Narutimo/compressor/КР_Рычков.pdf

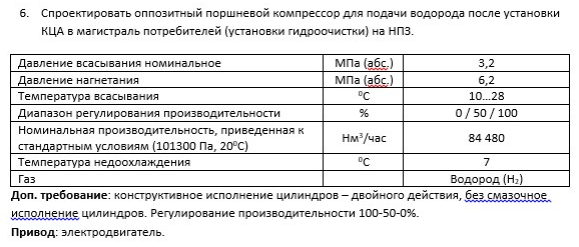
[picture p1: figure]

## Тепловой расчет

### Исодные данные

Давление всасывания | p вс := 3.2 MPa
Давление нагнетания | pн

:= 6.2 MPa

Tвс := 301.15Δ°C Температура всасывания

Номинальная производительность,
приведенная к стандартным условиям

Vн

84480

m

3

hr

:= |
Стандартная температру всасывания | Tс

:= 293.15Δ°C

Стандартное давление всасывания | p с

:= 101300 Pa

Недоохлаждение | ΔT | 7 := Δ°C

Газ - Водород Н2
k | 1.41 := Показатель адиабаты
Индивидуальная газовая постоянная | R | 4125 J kg K
:= |
Давление н.у. | p
0

:= 101325 Pa

Температура н.у. | T0

:= 273.15Δ°C

Массовый расход G

p

### 0 Vн

R T0

2.11

kg
s

:= =

## Расчет

## 1. Распределение давления по ступеням

Общее номенальное относительное повышение давления в компрессоре:

ε
к

pн
p
вс

:= = 1.938

Относительные потери давления в ступени I:
A := 2.66 | q | 0.25 :=
A , q - коэффициенты,учитывающие современное газодинамическое совершенство клапанов

δ
вс1 0.3

A

p
вс

### 1 Pa

q

- 0.3

2.66

### 3.2 MPa

Pa

0.25

:= | = | | = 0.019
δн1 | 0.7

A

pн

### 1 Pa

q

- 0.7

2.66

### 6.2 MPa

Pa

0.25

:= | = | | = 0.037

Усредненные давления p1 и p2:

p

1I | 1 δ
вс1 ( | ) - | p
вс | 3.14 106
:= | = | | Pa

p

2I | 1 δн1 ( | ) + | pн
- 6.431 106
:= | = | | Pa

Номинальное давление:

p

всI p

вс 3.2 106
:= | = | | Pa
pнI | pн

6.2 106
:= | = | | Pa

Относительное повышение давления в цилиндрах:

εцI

p
2I
p
1I

:= = 2.048

## 2. Определение коэффициента подачи

Определение коэффициентов сжимаемости

Избыточный объем газа | b | 0.6 10- 3

m

3

kg

:= |

β

b
273 R

0.6 10- 3

m

3

kg

273 4125

J
kg K
= | 5.328 10- 10

m s

2
- K
kg
= | = | - Показатель отклонения сжимаемости

v

### 0 R

T0
p
0
- 11.12

m

3

kg

:= =

СТВ I ступени:
TвсI | Tвс := | = 301.15 K

v

всI R

TвсI
p
всI

+ 273β

- 0.389

m

3

kg

:= | =

ρвсI

p

всI v

всI

p
0

v
0

:= | = 1.104

ξ

всI | ρвсI
| 273 Tвс
- 1.001

1
K
:= | = | - Коэффициент сжимаемости

СТН I ступени:

TнI Tвс εцI

k 1-
k
:= | | = 370.97 K
vнI | R
| TнI
| p
2I
| | + 273β
- 0.239

m

3

kg

:= | =

ρнI

p

2I vнI

p
0

v
0

:= | = 1.362
ξнI | ρнI
| 273 TнI
- 1.002

1
K
:= | =

mI

:= 1.4

Величина относительного мертвого объема:

amI := 0.06

λоI 1 amI

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
- - 1
:= - | | = 0.961

Коэффициент дросселирования:
Принимаем
λдрI := 0.98 | ступень высокого давления

Коэффициент подогрева:

λтI | 1 0.01 εцI := - | ( | ) - 1 = 0.99

Коэффициент плотности:

λплI := 0.97

Коэффициенты подачи ступеней:

λI | λоI λдрI | λтI | λплI := | | = 0.904

## 3. Определение основных размеров ступени

Производительность компрессора, приведенная к условиям всасывания:

Ve Vн

p
с
Tс

Tвс
p
вс
- 0.763

m

3

s

:= | =

Объем, описываемый цилиндром I ступени:

VhI

Ve
λI

2

0.422

m

3

s

:= =

Частота вращения вала - 490 об/мин

n
0

490

### 60 s

8.167

1
s
:= | = | частота вращение асинхронного электродвигателя
Средняя скоротсь поршня: | Cm
3.75

m
s
:= |
Ход поршня: | Sп

Cm

### 2 n0

:= | = 0.23 m
Относительный диаметр штока крейцпкофа: | αшт := 0.15
Диаметр цилиндра I ступени: | DI

### 4 VhI

π Sп

- n
0
- 2 αшт

2

:= | = 0.381 m

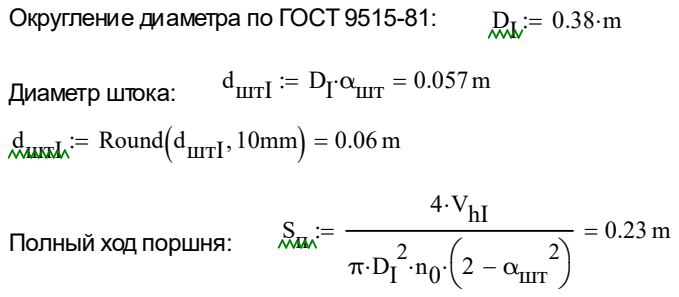
[picture p2: figure]
Округление диаметра по ГОСТ 9515-81:; dштI; DI αшт :=; = 0.057 m Диаметр штока:; Round dштI :=; 4 VhI; 2 αшт; = 0.23 m Полный ход поршня:

Уточнение средней скорости поршня:

Cm

### 2 Sп

- n
0
- 3.763

m
s
:= | =

Проверка:
Sп

n
0

2
- 15.366

m

s

2

= ψ

Sп
DI

:= = 0.606

Уточнение описанных объемов цилиндров:

VhI

π DI

2
- 2 αшт

2

4

Sп

- n
0
- 0.422

m

3

s

:= | =

Рабочие площади:

FпI

π DI

2

4

0.113 m2
:= | = | FпшI

π DI

2
- 1 αшт

2

4

0.111 m2
:= | =

Для I поршня:
PгвI | p
2I FпI | p
1I FпшI | p
0
FпI FпшI | + ( | ) -

- 3.811 105
:= | = | | N
PгнI | p
1I FпI | p
2I FпшI | p
0
FпI FпшI | + ( | ) -

- -3.572 105
:= | = | | N

## Построение индикаторных диаграмм:

Мертвые объемы:

VмI | VhI amI | 0.025

m

3

s

:= | =
V1I | VмI VhI + | 0.447

m

3

s

:= | =
V2I | V1I

p
1I
p
2I

1
k
- 0.269

m

3

s

:= | =
V4I | VмI

p
2I
p
1I

1
k
- 0.042

m

3

s

:= | =
v | VмI 1.01 VмI , | | V1I := | ..

p

Iн( ) p v
1I

V1I
v

k
- | V2I v V1I if |

p

2I | VмI < v V2I if | <

:=

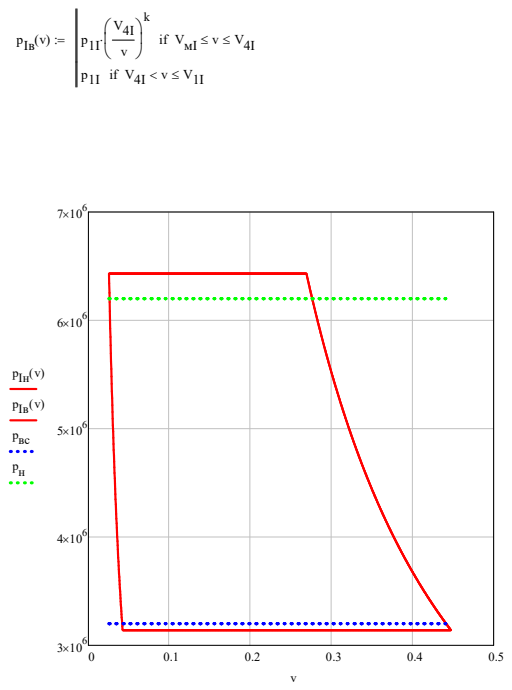
[picture p3: page 7]
VмI v V4I if

### Мощность привода компрессора

Коэффициенты возврата энергии:

ΘI

### 1 amI εцI

1
k
- 1
:= - | | = 0.96

### Определение мощности:

NиндI | p
1I VhI | ΘI

k
k 1 -
- εцI

k 1-
k
- 1
- 1.014 106
:= | = | | W
Nинд.к | 2NиндI 2.029 106
:= | = | | W

ηмех := 0.98

Ne0

Nинд.к
ηмех

2.07 106
:= | = | | W | мощность на валу компрессора
Запас по мощности | n
з
| | | := 10%

Ne

Nинд.к
ηмех
| 1 nз
( | ) + | 2.277 106
:= | = | | W | мощность электродвигателя

Привод компрессора осуществляется от асинхронного двигателя через упругую муфту. Зададимся частотой вращения вала ЭД:
n
0
500 min- 1 | 8.333
| 1 s
:= | =
ω0

2π n
0
- 52.36

1
s

:= =

Mном

Ne
ω0

4.349 104
:= | = | | J

Асинхронная частота вращения при заданной нагрузке n 490min- 1
:=

## Динамический расчет

### Исходные данные

Радиус кривошипа | Rк

Sп
2
:= | = 0.115 m
Отношение радиуса кривошипа к длине шатуна | λR

1
5

:=

Длина шатуна | lш

Rк
λR
:= | = 0.576m
ω | 2π n
0
- 52.36

1
s
:= | | =
α := 0 0.36deg , | | .. 360deg
β( ) | asin α | λR
:= | ( | ) sin( ) α

Sx

( ) | R α | к
( | ) 1 cos - | ( ) α

λR
4
+ | ( | ) 1 cos 2 - | ( ) α
:= |
Sx.1( ) | R α | к
:= | ( | ) 1 cos - | ( ) α

Sx.2( ) α

λR
4

Rк

:= | ( | ) 1 cos 2 - | ( ) α

Cx

( ) | R α | к

ω

| sin( | | ) α β α + ( )
cos( | ) β α( )
:= |
Cx.1( ) | R α | к
:= | ωsin( ) α
Cx.2( ) | R α | к

ω

λR
2
:= | | sin 2( ) α

jx

( ) α
α

Cx

| ( ) α

d
d
:= | ω

jx.1( ) α
α
| Cx.1( ) α

d
d
:= | ω

jx.2( ) α
α

Cx.2( ) α

d
d
:= | ω

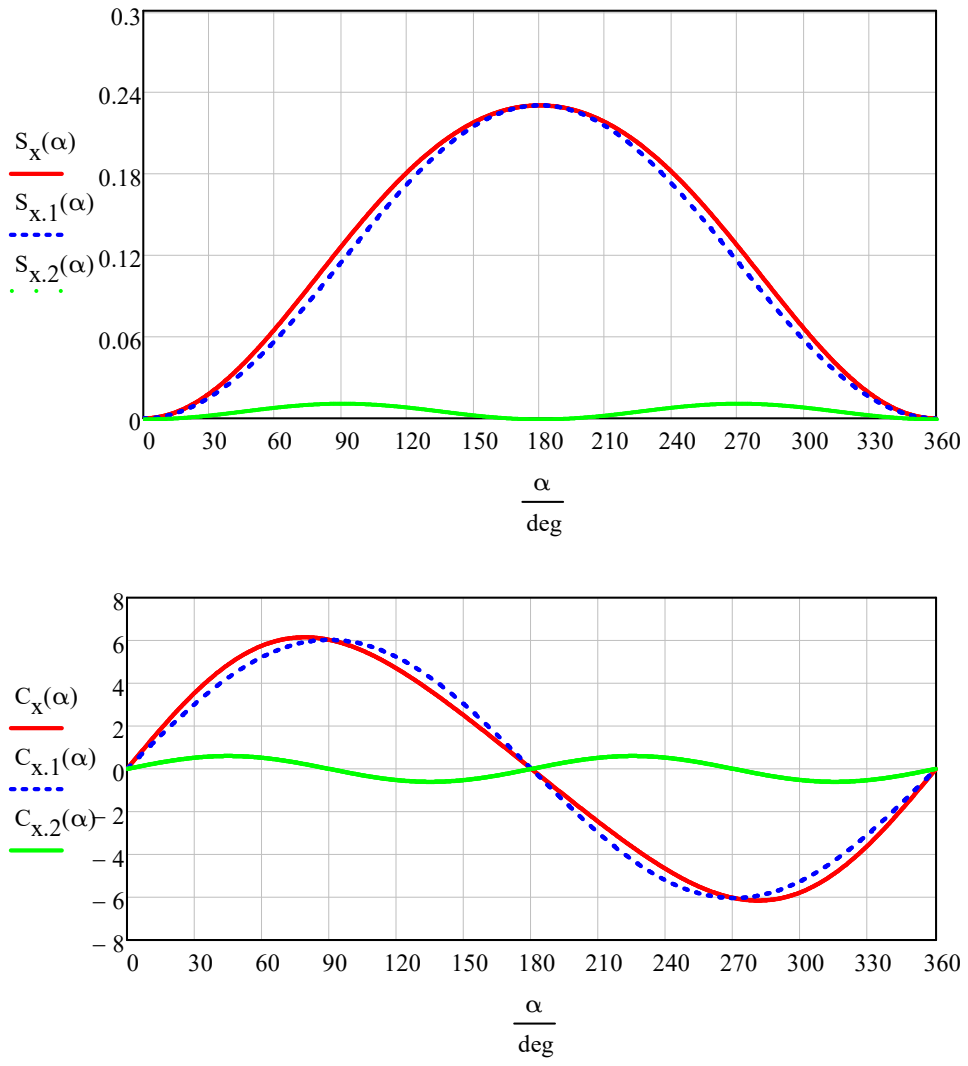
[picture p4: page 10]
deg

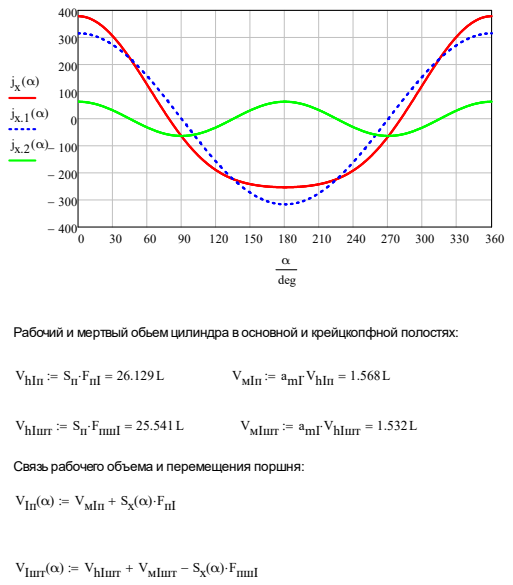
[picture p5: page 11]
deg; VhIп; FпI :=; VмIп; amI VhIп :=; VhIшт; FпшI :=; VмIшт; amI VhIшт :=; VIп( ); мIп Sx; VIшт( ); hIшт VмIшт +; ( ) F α пшI :=

Рабочий и мертвый обьем цилиндра в основной и крейцкопфной полостях:

Связь рабочего объема и перемещения поршня:

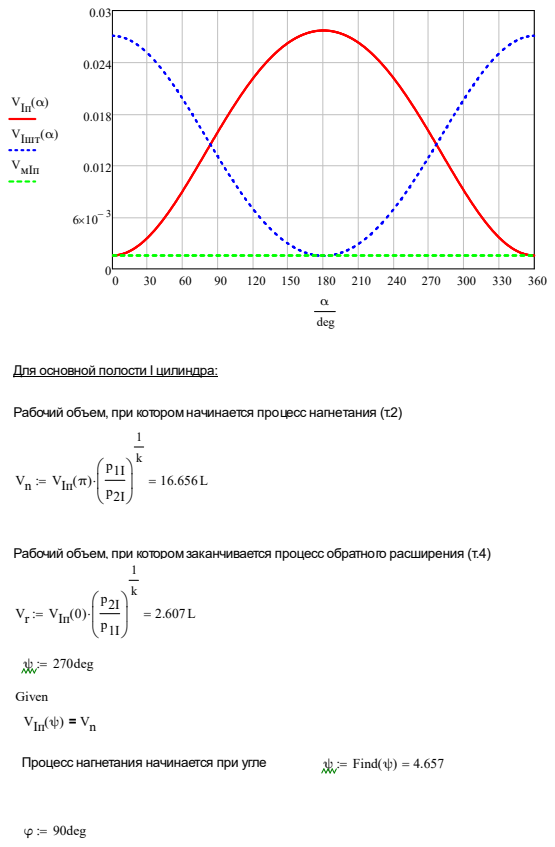
[picture p6: page 12]
VIп( ) α; VIшт( ) α; VмIп; deg; VIп( ) π; VIп( ) 0; ψ := 270deg; Given; VIп( ) V ψ; Процесс нагнетания начинается при угле; ψ := Find( ) 4.657 ψ =; φ := 90deg

Для основной полости I цилиндра:

Рабочий объем, при котором начинается процесс нагнетания (т.2)

Рабочий объем, при котором заканчивается процесс обратного расширения (т.4)

Given

VIп( ) V φ | r =

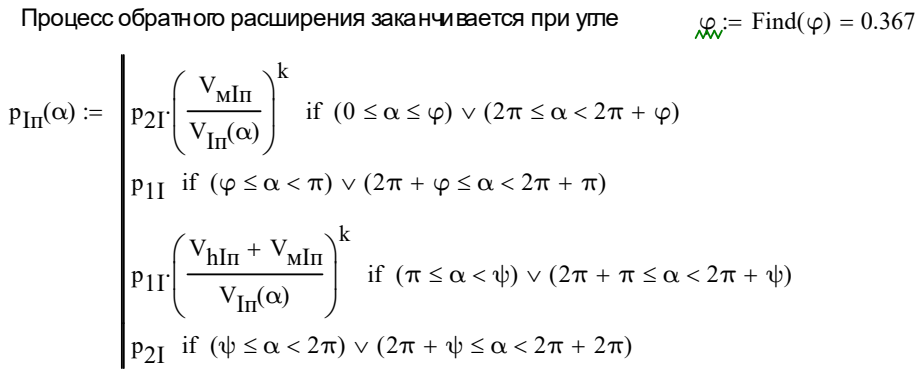
[picture p7: figure]
VмIп; VIп( ) α; VhIп VмIп +

Процесс обратного расширения заканчивается при угле | φ := Find( ) 0.367 φ =
- | if ( | ) | 2 0 α φ ( | ) π α < 2π φ +
1I if ( | ) | 2 φ α < π ( | ) π φ + α < 2π π +
- | if ( | ) | 2 π α < ψ ( | ) π π + α < 2π ψ +
2I if ( | ) | 2 ψ α < 2π ( | ) π ψ + α < 2π + 2π

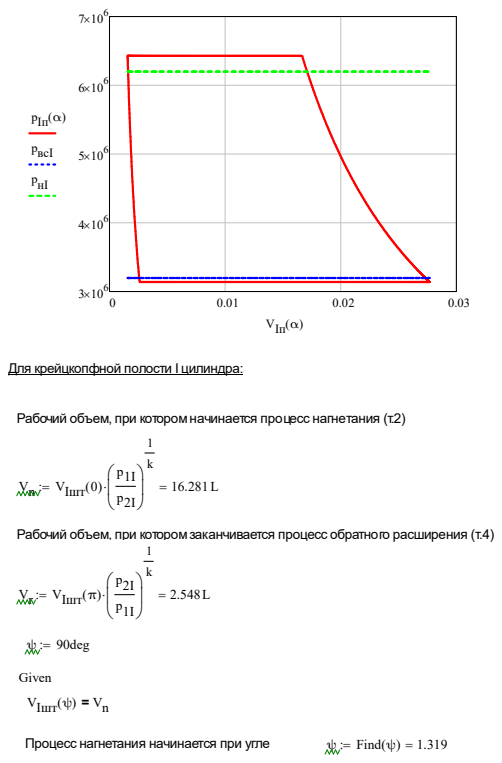
[picture p8: page 14]
всI; pнI; VIп( ) α; VIшт( ) 0; VIшт( ) π; ψ := 90deg; Given; VIшт( ) V ψ; Процесс нагнетания начинается при угле; ψ := Find( ) 1.319 ψ =

Для крейцкопфной полости I цилиндра:

Рабочий объем, при котором начинается процесс нагнетания (т.2)

Рабочий объем, при котором заканчивается процесс обратного расширения (т.4)

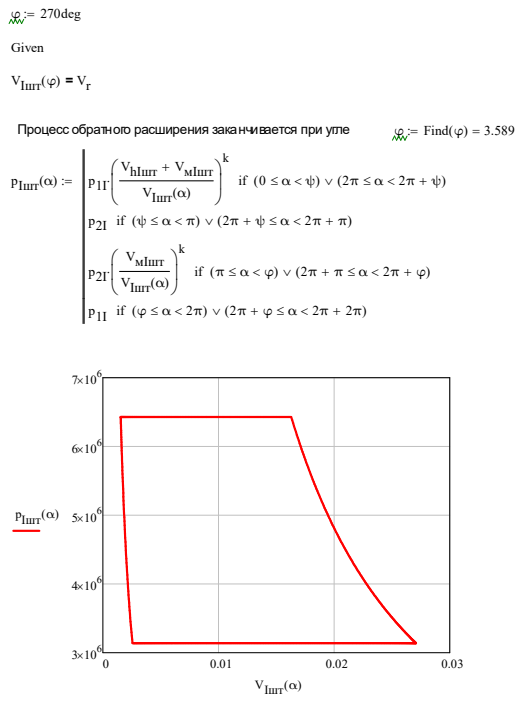
[picture p9: page 15]
φ := 270deg; Given; VIшт( ) V φ; Процесс обратного расширения заканчивается при угле; φ := Find( ) 3.589 φ =; Iшт( ); VhIшт VмIшт +; VIшт( ) α; VмIшт; Iшт( ) α

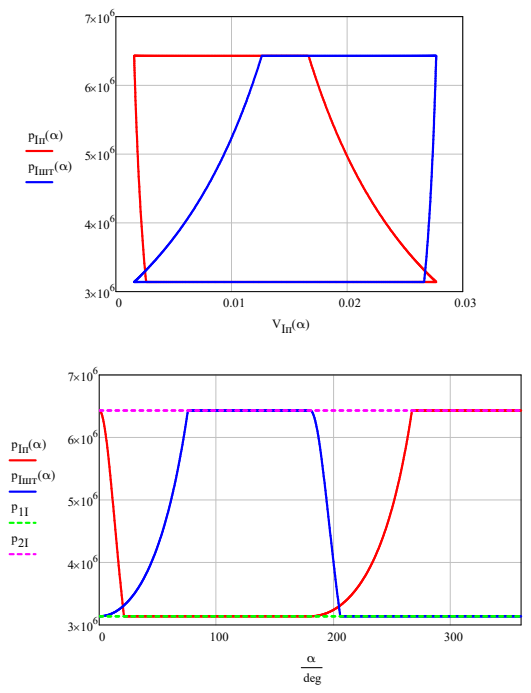
[picture p10: page 16]
Iшт( ) α; VIп( ) α; deg

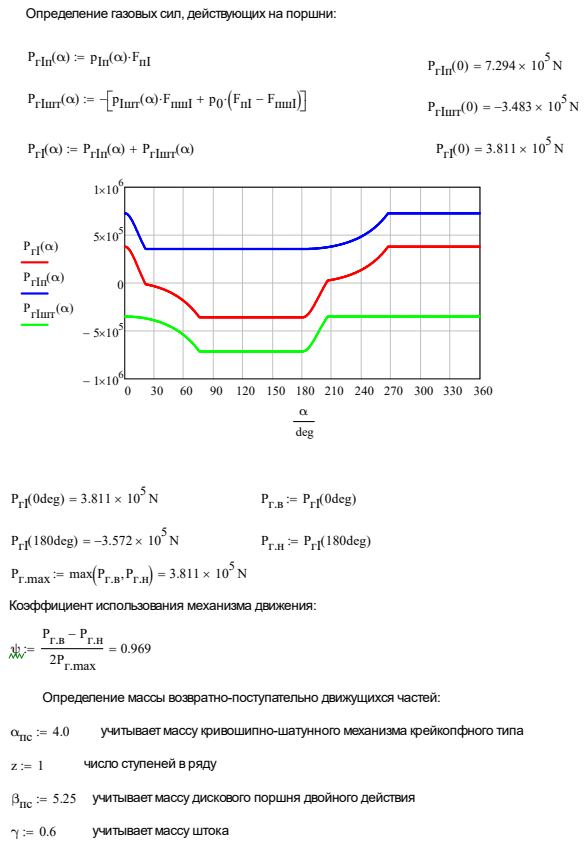
[picture p11: page 17]
PгIп( ); PгIп( ) 7.294 10 0; PгIшт( ); Iшт( ) F α пшI; FпI FпшI; PгI( ); гIп( ) P α; гIшт :=; PгI( ) 3.811 10 0; PгIп( ) α; гIшт( ) α; deg; PгI(; ) 3.811 10 0deg; PгI :=; ) 0deg; 3.572 180deg; ) 180deg; Pг.max; max Pг.в Pг.н , (; αпс := 4.0; учитывает массу кривошипно-шатунного механизма крейкопфного типа; число ступеней в ряду; учитывает массу штока

Определение газовых сил, действующих на поршни:

Коэффициент использования механизма движения:
2Pг.max

Определение массы возвратно-поступательно движущихся частей:

βпс := 5.25 учитывает массу дискового поршня двойного действия

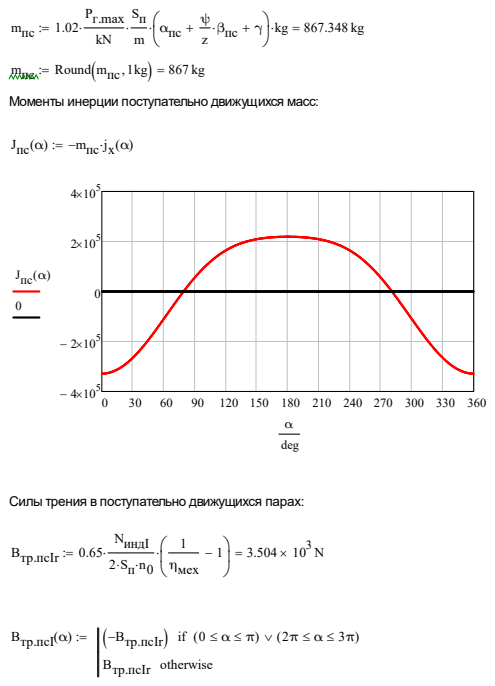
[picture p12: page 18]
mпс; Pг.max; αпс; βпс +; Round mпс :=; Jпс( ); Jпс( ) α; deg; Bтр.псIr; NиндI; 1 ηмех; Bтр.псI( ); тр.псIr (

Моменты инерции поступательно движущихся масс:

Силы трения в поступательно движущихся парах:

Bтр.псIr otherwise

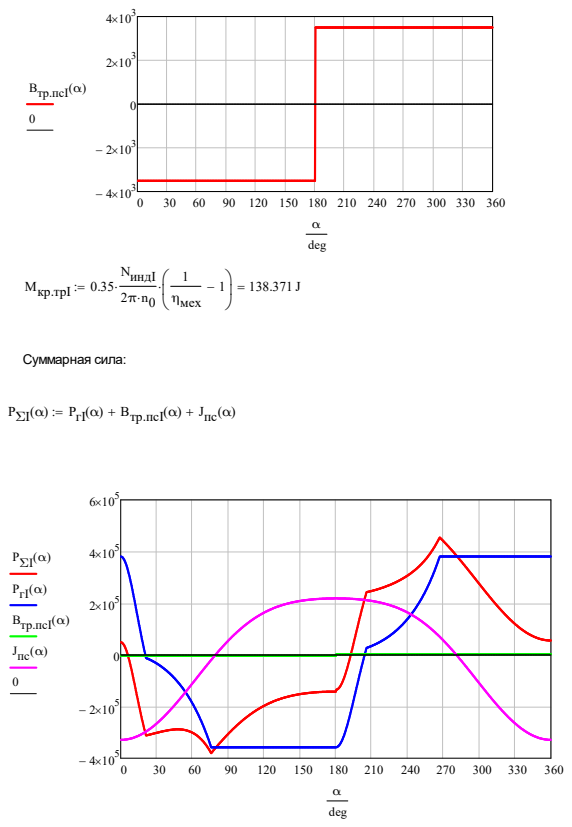
[picture p13: page 19]
Bтр.псI( ) α; deg; Mкр.трI; NиндI; 1 ηмех; Суммарная сила:; PΣI; тр.псI +; Jпс :=; PгI( ) α; Jпс( ) α

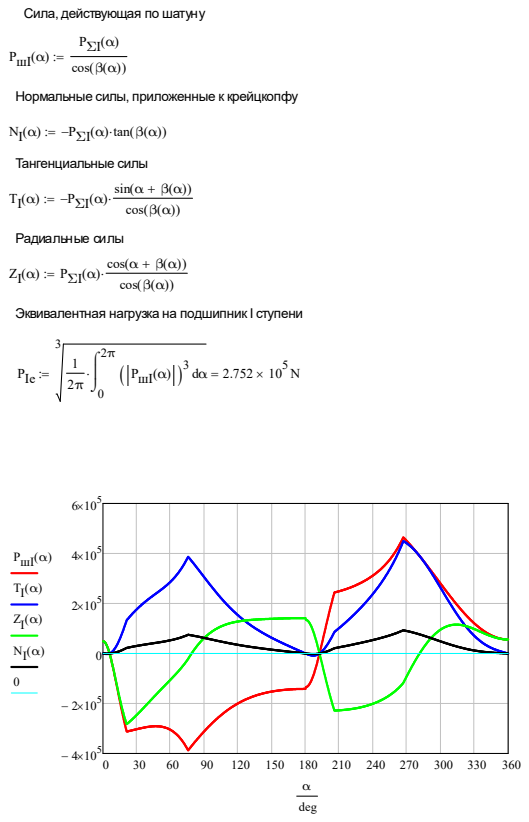
[picture p14: page 20]
PшI( ) α; PΣI; cos(; ( ) α tan(; Тангенциальные силы; sin(; Радиальные силы; PIe; ) PшI( ) α; deg

Сила, действующая по шатуну

Нормальные силы, приложенные к крейцкопфу

Эквивалентная нагрузка на подшипник I ступени

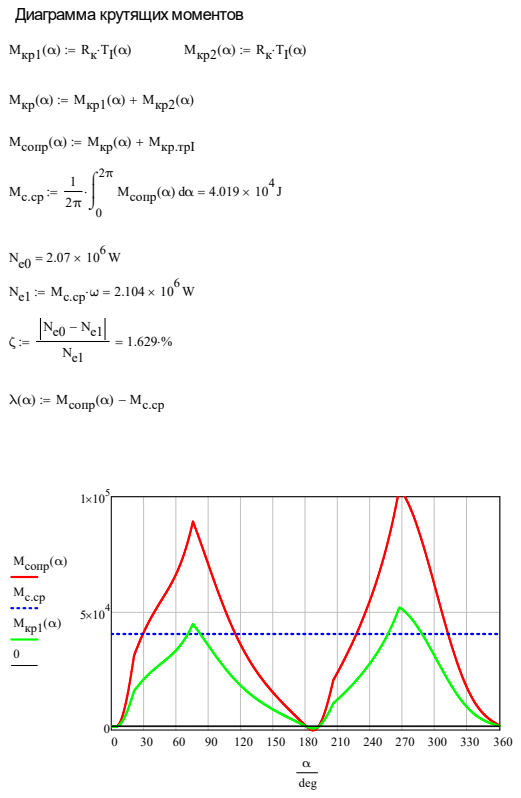
[picture p15: page 21]
Mкр1( ); Mкр2( ); Mкр( ); Mсопр( ); кр.трI :=; M α сопр( ) α; Mсопр( ) M α; Mсопр( ) α; Mкр1( ) α; deg

Диаграмма крутящих моментов

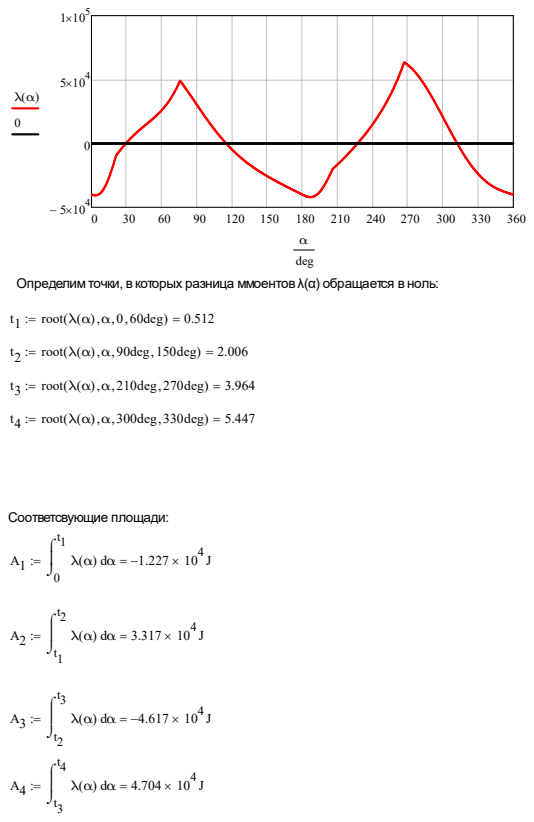
[picture p16: page 22]
deg; := root(; ) 0.512 λ α( ), α, 0, 60deg =; ) 2.006 λ α( ), α, 90deg, 150deg =; ) 3.964 λ α( ), α, 210deg, 270deg =; ) 5.447 λ α( ), α, 300deg, 330deg =; Соответсвующие площади:

Определим точки, в которых разница ммоентов λ(α) обращается в ноль:

A5
t4

2π
λ α( ) α
d | 2.177 - | 104
:= | = | | J
A( ) | A α | 1

0 < α t1

if |
A1 A2 ( | ) + | t1
< α t2

if

A1 A2

+ | A3 ( | ) + | t2
< α t3

if

:=

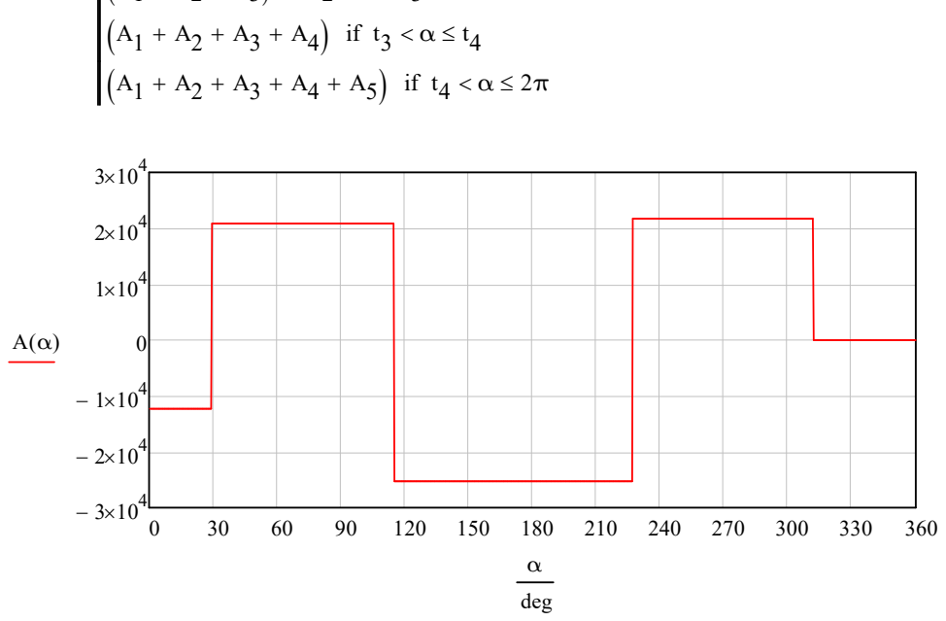
[picture p17: figure]
deg

Amax | A 300deg ( | ) 2.177 104
:= | = | | J
Amin | A 200deg ( | ) | 2.527 - | 104
:= | = | | J

AΣ

Amax Amin - | 4.704 104
:= | = | | J

Расчет маховика

Тебуемая степень неавномерсности частоты вращения вала

δ

1
80

:=

Jm

AΣ

4 ( ) πn

2
- δ

1.429 103
- m

2
:= | = | kg Необходимый момент инерции маховика

Максимально допустимая окружная скорость маховика

Cmax 40

m
s

:=

Максимальный диаметр маховика | Dm.max

Cmax
π n
0

:= | = 1.528 m
Примем наружный диаметр маховика | Dm := 1.5m

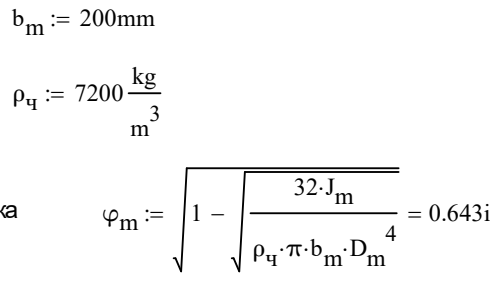
[picture p18: figure]

Толщина маховика | bm := 200mm
Плотность чугуна СЧ20 | ρч

Отношение внутреннего диаметра маховика к наружнему

Масса маховика | Mm | ρч
πbm

Dm

2

4

- 1 φm

2
- 3.596 103
:= | = | | kg

## Расчет дискового поршня

I ступень
Диаметр поршня | Dп | DI
:= | = 0.38 m
Диаметр штока | dштI = 0.06 m
Диаметр втулки штока | d
вт | 2dштI := | = 0.12 m

Расчет напряжений в днище поршня (по Тимошенко)

a

Dп
2
:= | b

d
вт
2

:= Геометрические параметры

Аспектное соотношение | k ab

a
b

:= = 3.167

Распределенная нагрузка
q

Pг.max
FпI

3.36 106
:= | = | | Pa

Коэффициент напряжения
(по таблице) | vx

3
4
:= | vy

1.54
2.23

:=

kσ

linterp vx vy , | k
ab := | ( | ) , | = 1.655

Допустимое напряжение в днище поршня | σдоп := 100MPa
Минимальная толщина днища поршня | δ ст.п.min

kσ

q a

2

σдоп

:= | = 0.045 m

δ

ст.п | Round δ
ст.п.min := | ( | ) , 1mm = 0.045 m
Рекомендуемые диапозоны толщин | | | 0.1 Dп | = 0.038 m
| | | 0.2 Dп | = 0.076 m

Рабочий зазор между цилиндром и поршнем

ε
p

:= 0.002

Δ1p ε
p DI
- 7.6 10- 4
:= | = | | m

## Расчет поршневых колец

Максимальный перепад в I ступени | ΔpI | p
| | | | 2I p
1I - | 3.292 106
:= | = | | Pa
Число уплотняющих колец | n
| | | укI := 3
Толщина кольца при | DI
= 0.38 m | tкI := 12mm
Высота кольца | b

кI := 12mm

Температура всасывания | TвсI = 301.15 K
Температура нагнетания | TнI = 370.97 K
Перепад температур | ΔTI | TнI TвсI := | - | = 69.82 K

Материал поршневых колец - фторопласт
Коэффициент линейного расширения | αфп | 13 10- 5
| | | | K
- 1
:=
Предел прочности на разрыв | σв.р := 15.7MPa
на сжатие | σв.с := 21MPa
Модуль упругости при сжатии | E | 0.063 104
:= | | MPa
Тепловой зазор в замке | a
t | αфп ΔTI
- π DI
:= | = 0.011 m

Опорные кольца

Максимальное давление от массы
поршня и 1/2 штока

Pп.доп := 0.25bar

Масса поршня и 1/2 штока | mпш | 1.02

Pг.max
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
:= | | kg = 482.271 kg
Вес поршня и 1/2 штока | Gпш | mпшg 4.729 103
:= | = | | N
Число опорных колец | Zок := 2
Минимальная высота опорного кольца | b
ок
| | | Gпш
| | Zокπ DI
- Pп.доп
:= | = 0.079 m | d

клI := 100mm

Расстояние от днища поршня до опорного кольца

eк

:= 15mm

Примерная высота поршня | HпI | 2 eк
b
ок + | b
кI ( | ) + | b
кI 2 nукI := | + | ( | ) | - 1 = 0.272 m

hпi

HпI
DI
:= | = 0.717
HпI.max | b
кI 2 nукI ( | ) | + 1

4
3

b

ок + | d
клI := | + | = 0.29 m | HпI.max Sп
+ | = 0.52 m

HпI.max
DI

= 0.762

Подбор клапанов по пропускной способности Допустимые потери в клапане: ΔNIвс.кл := 7.4%

ΔNIн.кл := 5.8%

Скорость звука | a
Iвс | k R TвсI | 1.323 103

m
s
:= | =

a

Iн | k R TнI | 1.469 103

m
s
:= | =
Критерий скорости | FmaxIвс := 0.18

FmaxIн := 0.16

Скорректированный для водорода критерий скорости

FwIвс FmaxIвс

1.4
k
:= | | = 0.179
FwIн | FmaxIн

1.4
k
:= | | = 0.159

Допустимая условная скорость газа в клапане

wфIвс | FwIвс a
Iвс | 237.378

m
s
:= | =
wфIн | FwIн a
Iн | 234.188

m
s
:= | =

Число всасывающих или нагнетательных клапанов на полость цилиндра

I ступени ZклI := 2

Необходимое значение эквивалентной площади клапана

ФIвс

FпICm
ZклI wфIвс

8.989 10- 4
- m

2
:= | =

ФIн

FпICm
ZклI wфIн

9.112 10- 4
- m

2
:= | =

Размеры трубопроводов на всасивании и нагнетании I ступени

Рекомендуемая скорость газа в трубопроводе | wрек | 14

m
s

:=

Плотность газа в трубопроводе | ρ1I

p
вс
R Tвс

2.576

kg

m

3

:= | = | G 2.11
kg
s

=

Диаметр всасывающего трубопровода | DNвсI

4G
π ρ1I | wрек
:= | = 0.273m

Плотность газа в трубопроводе | ρ2I

pн
R TнI

4.052

kg

m

3

:= =

Диаметр нагнетающего трубопровода DNнI

### 4 G

π ρ2I | wрек
:= | = 0.218 m
