Narutimo/compressor/3_Лист_1.dxf

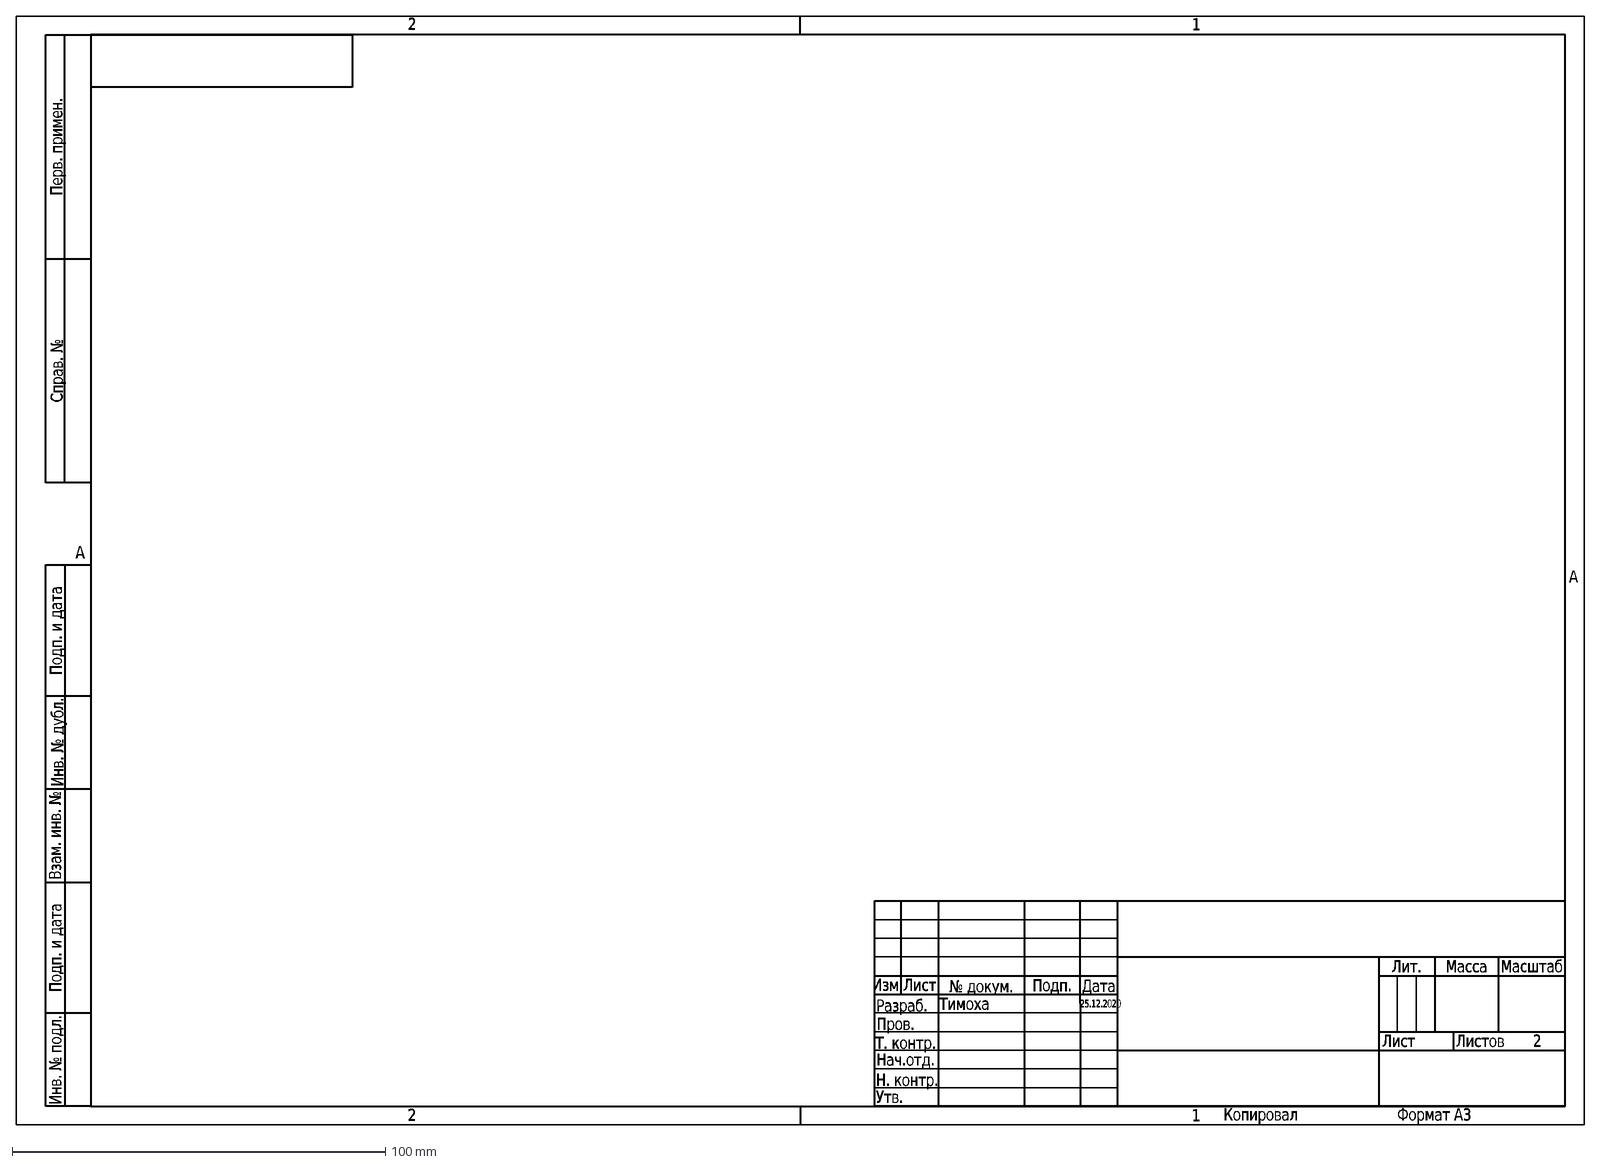
[picture p19: CAD file, 2020-12-25]
3_Лист_1.dxf
Формат А3
1
2
A
Нач.отд.
Тимоха
25.12.2020
Изм.
Лист
№ докум.
Подп.
Дата
Разраб.
Пров.
Т. контр.
Н. контр.
Утв.
Лит.
Масса
Масштаб
Листов
Копировал
Инв. № подл.
Подп. и дата
Взам. инв. №
Инв. № дубл.
Справ. №
Перв. примен.
