Narutimo/compressor/Клапан/Шпилька М24-6gx48 ГОСТ 22038-76.igs

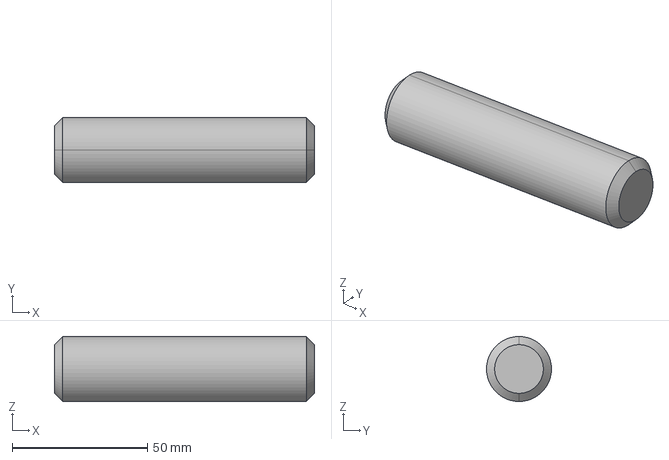
[picture p20: CAD file, 2020-11-17]
Клапан/Шпилька М24-6gx48 ГОСТ 22038-76.igs
96.0 x 24.0 x 24.0 mm
