Narutimo/compressor/Клапан/Ограничитель .igs

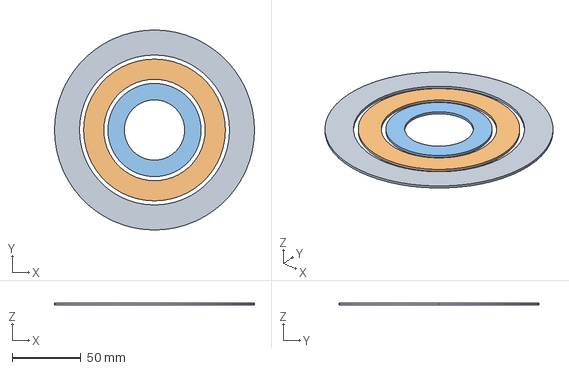
[picture p21: CAD file, 2020-11-17]
Клапан/Ограничитель .igs
146.0 x 146.0 x 1.50 mm
