Narutimo/compressor/Клапан/Гайка М24-6H ГОСТ 5915-70.igs

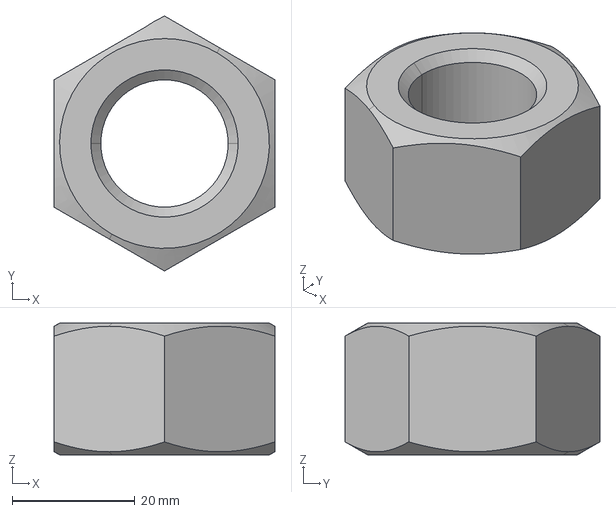
[picture p22: CAD file, 2020-11-17]
Клапан/Гайка М24-6H ГОСТ 5915-70.igs
36.0 x 41.6 x 21.5 mm
