Narutimo/compressor/Клапан/Седло .igs

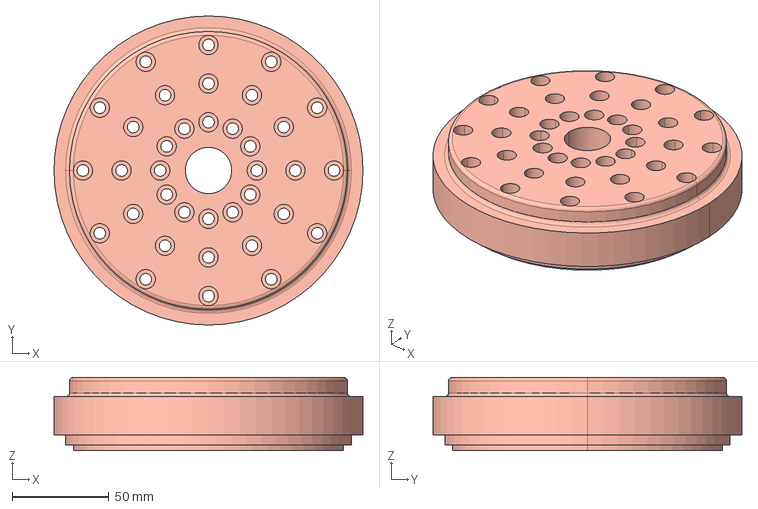
[picture p23: CAD file, 2020-11-17]
Клапан/Седло .igs
160.0 x 160.0 x 38.0 mm
