Narutimo/compressor/Клапан/Пружина_1.igs

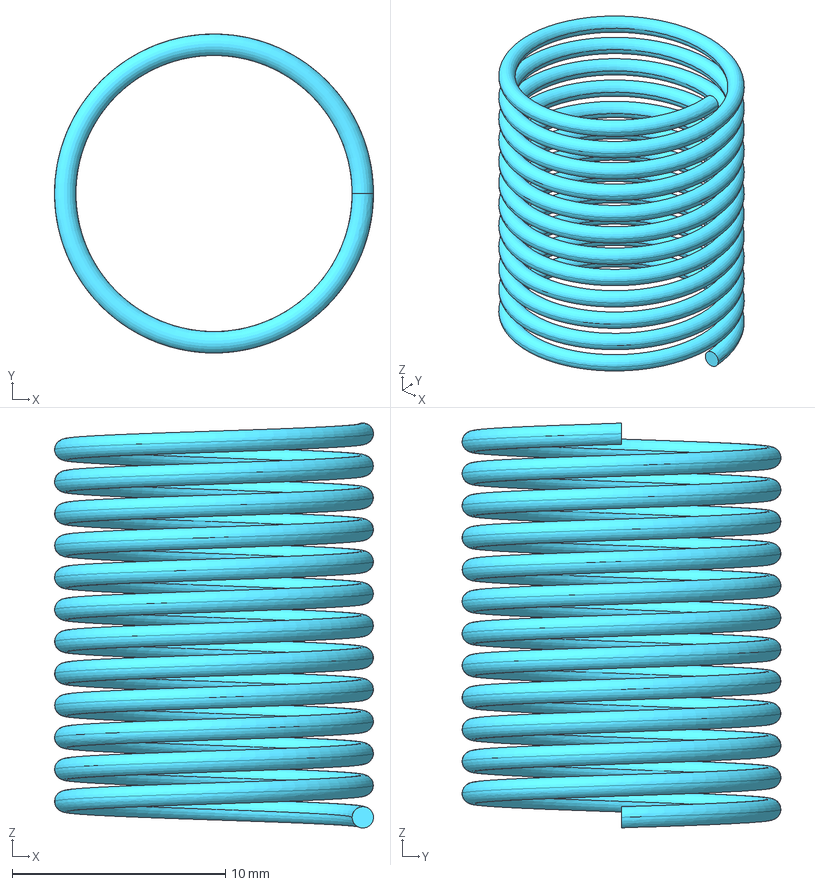
[picture p24: CAD file, 2020-11-17]
Клапан/Пружина_1.igs
15.0 x 15.0 x 19.0 mm
