Narutimo/compressor/Клапан/Пластина.igs

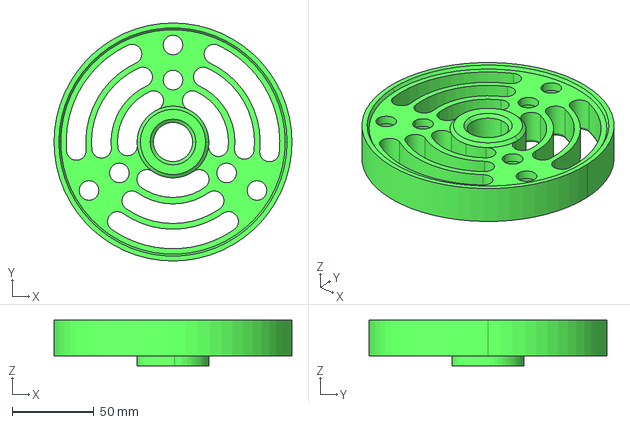
[picture p25: CAD file, 2020-11-17]
Клапан/Пластина.igs
146.0 x 146.0 x 28.0 mm
