Narutimo/compressor/(list of files, cad)

Other CAD files:
3_Лист_2.dxf
Сборка3.dwg
Сальник.dwg
Цилиндр1.dwg
OldVersions/Балка.0003.ipt
OldVersions/Башмак.0008.ipt
OldVersions/Башмак_MIR.0002.ipt
OldVersions/Болт шатуна.0001.ipt
OldVersions/В сальник.0007.ipt
OldVersions/Вал.0008.ipt
OldVersions/Верхняя часть коренного подшипника.0002.ipt
OldVersions/Верхняя часть поршня.0007.ipt
OldVersions/Вилка.0002.ipt
OldVersions/Втулка палец шатун.0001.ipt
OldVersions/Втулка под палец.0004.ipt
OldVersions/Втулка под палец_MIR.0002.ipt
OldVersions/Втулка.0006.ipt
OldVersions/Втулка_CPY.0001.ipt
OldVersions/Гайка шток-поршень.0001.ipt
OldVersions/Гайка шток.0003.ipt
OldVersions/Деталь5.0001.ipt
OldVersions/Деталь5_CPY.0001.ipt
OldVersions/Деталь5_CPY.0003.ipt
OldVersions/Деталь5_CPY.0004.ipt
OldVersions/Деталь6.0001.ipt
OldVersions/Деталь6_CPY.0001.ipt
OldVersions/Деталь6_CPY.0002.ipt
OldVersions/Для регулировки 1.0001.ipt
OldVersions/Для регулировки 2.0001.ipt
OldVersions/Для регулировки 3.0003.ipt
OldVersions/Для регулировки 4.0002.ipt
OldVersions/Дроссельное кольцо.0002.ipt
OldVersions/Дроссельное кольцо.0003.ipt
OldVersions/Картер всборе.0008.iam
OldVersions/Картер.0023.ipt
OldVersions/Клапан 2.0001.ipt
OldVersions/Клапан0.0007.iam
OldVersions/Клапан1.0003.iam
OldVersions/Клапан2.0001.iam
OldVersions/Кольцо поршень-шток верх.0003.ipt
OldVersions/Кольцо поршень-шток низ.0002.ipt
OldVersions/Кольцо поршня.0001.ipt
OldVersions/Кольцо сальника.0009.ipt
OldVersions/Корпус дросселя.0004.ipt
OldVersions/Корпус дросселя.0007.ipt
OldVersions/Корпус маслосъемника.0003.ipt
OldVersions/Корпус сальника 1.0001.ipt
OldVersions/Корпус сальника 1.0002.ipt
OldVersions/Корпус сальника 1.0003.ipt
OldVersions/Корпус сальника 2.0001.ipt
OldVersions/Корпус сальника 2.0002.ipt
OldVersions/Корпус сальника 2.0003.ipt
OldVersions/Корпус сальника 3.0003.ipt
OldVersions/Корпус сальника 4.0002.ipt
OldVersions/Корпус сальника 4.0003.ipt
OldVersions/Корпус сальника 4.0004.ipt
OldVersions/Корпус сальника перегородка 1.0003.ipt
OldVersions/Корпус сальника.0004.ipt
OldVersions/Корпус сальника.0008.ipt
OldVersions/Корпус сальника0.0003.ipt
OldVersions/Крейцкопф.0009.ipt
OldVersions/Крейцкопф_CPY.0001.ipt
OldVersions/Крейцкопф_CPY.0002.ipt
OldVersions/Крейцкопфф.0009.iam
OldVersions/Крышка воды зад.0001.ipt
OldVersions/Крышка водяной рубашки.0001.ipt
OldVersions/Крышка картера 1.0005.ipt
OldVersions/Крышка картера 2.0004.ipt
OldVersions/Крышка картера 2.0005.ipt
OldVersions/Крышка картера 3.0003.ipt
OldVersions/Крышка картера 4.0001.ipt
OldVersions/Крышка коренного подшипника1.0002.ipt
OldVersions/Крышка перегородки11.0006.ipt
OldVersions/Крышка перегородки12.0003.ipt
OldVersions/Крышка перегородки21.0003.ipt
OldVersions/Крышка перегородки22.0003.ipt
OldVersions/Крышка рубашки охлаждения.0006.ipt
OldVersions/Крышка рубашки охлаждения_MIR1.0001.ipt
OldVersions/Крышка сальников.0013.ipt
OldVersions/Крышка стакана.0006.ipt
OldVersions/Крышка стакана_CPY.0001.ipt
OldVersions/Крышка стенки картера верх.0007.ipt
OldVersions/Крышка стенки картера низ.0004.ipt
OldVersions/Крышка фонаря 1.0008.ipt
OldVersions/Крышка фонаря 1_MIR1.0003.ipt
OldVersions/Крышка фонаря 2.0010.ipt
OldVersions/Крышка фонаря 2_MIR1.0003.ipt
OldVersions/Крышка цилиндра 1.0012.ipt
OldVersions/Крышка цилиндра 2.0012.ipt
OldVersions/Крышка цилиндра 2_CPY.0001.ipt
OldVersions/Крышка цилиндра 2_CPY.0002.ipt
OldVersions/Крышка цилиндра 2_CPY.0003.ipt
OldVersions/Маслосъемная пружина.0002.ipt
OldVersions/Маслосъемное кольцо.0002.ipt
OldVersions/Маслосъемное кольцо_CPY.0001.ipt
OldVersions/Мое седло.0001.ipt
OldVersions/Мой ограничитель.0001.ipt
OldVersions/Моя пластина.0001.ipt
OldVersions/Нижняя часть коренного подшипника.0001.ipt
OldVersions/Нижняя часть поршня.0006.ipt
OldVersions/Ограничитель.0001.ipt
OldVersions/Опорное кольцо.0001.ipt
OldVersions/Палец.0004.ipt
OldVersions/Палец_CPY.0001.ipt
OldVersions/Пластина.0001.ipt
OldVersions/Пластина.0002.ipt
OldVersions/Под стяжку.0001.ipt
OldVersions/Почти готово.0070.iam
OldVersions/Почти готово_CPY.0050.iam
OldVersions/Придав перегородки1.0002.ipt
OldVersions/Прокладка воды зад.0001.ipt
OldVersions/Прокладка клапана.0002.ipt
OldVersions/Прокладка клапана_CPY.0001.ipt
OldVersions/Прокладка крейцкопф.0003.ipt
OldVersions/Прокладка крейцкопф_CPY.0001.ipt
OldVersions/Прокладка крейцкопф_CPY.0002.ipt
OldVersions/Прокладка крышек цилиндра.0001.ipt
OldVersions/Прокладка крышки фонаря 1.0001.ipt
OldVersions/Прокладка крышки фонаря 1_CPY.0001.ipt
OldVersions/Прокладка крышки фонаря 1_CPY.0002.ipt
OldVersions/Прокладка крышки фонаря 1_CPY.0003.ipt
OldVersions/Прокладка крышки фонаря 1_CPY.0004.ipt
OldVersions/Прокладка крышки фонаря 1_CPY_MIR.0005.ipt
OldVersions/Прокладка крышки фонаря 2.0001.ipt
OldVersions/Прокладка крышки фонаря 2_CPY.0001.ipt
OldVersions/Прокладка крышки фонаря 2_CPY.0002.ipt
OldVersions/Прокладка крышки фонаря 2_CPY.0003.ipt
OldVersions/Прокладка крышки фонаря 2_CPY.0004.ipt
OldVersions/Прокладка крышки фонаря 2_CPY_MIR.0005.ipt
OldVersions/Прокладка рубашки охлаждения.0007.ipt
OldVersions/Прокладка рубашки охлаждения_MIR.0001.ipt
OldVersions/Пружина дросселя.0003.ipt
OldVersions/Пружина сальника.0002.ipt
OldVersions/Пружина сальника.0003.ipt
OldVersions/Пружина.0001.ipt
OldVersions/Сальник 1.0002.iam
OldVersions/Сальник.0009.iam
OldVersions/Сборка1.0004.iam
OldVersions/Сборка3.0023.iam
OldVersions/Сборка4.0001.iam
OldVersions/Седло.0005.ipt
OldVersions/Стакан1.0006.ipt
OldVersions/Стакан2.0004.ipt
OldVersions/Стопорное кольцо.0001.ipt
OldVersions/Стопорное кольцо_MIR.0001.ipt
OldVersions/Стяжка.0002.ipt
OldVersions/Уплотнение фонарь.0001.ipt
OldVersions/Уплотнительное кольцо_CPY.0001.ipt
OldVersions/Фланецгайка.0005.ipt
OldVersions/Фланецгайка_CPY.0001.ipt
OldVersions/Фланецгайка_CPY.0002.ipt
OldVersions/Фонарь.0018.ipt
OldVersions/Фонарь_CPY.0005.ipt
OldVersions/Фонарь_CPY.0007.ipt
OldVersions/Фонарь_CPY.0009.ipt
OldVersions/Цилиндр.0004.ipt
OldVersions/Цилиндр1.0007.ipt
OldVersions/Цилиндр2.0015.ipt
OldVersions/Цилиндр2_CPY.0001.ipt
OldVersions/Цилиндр2_CPY.0002.ipt
OldVersions/Цилиндр2_CPY.0003.ipt
OldVersions/Цилиндр2_CPY.0004.ipt
OldVersions/Цилиндр2_CPY.0005.ipt
OldVersions/Цилиндр2_CPY.0006.ipt
OldVersions/Шатун.0014.ipt
OldVersions/Шток.0004.ipt
OldVersions/Шток.0007.ipt
OldVersions/Шток_CPY.0001.ipt
OldVersions/Шток_CPY.0002.ipt
OldVersions/Шток_CPY.0003.ipt
OldVersions/Шток_CPY.0004.ipt
OldVersions/Шток_CPY.0005.ipt
Балка.ipt
Башмак.ipt
Башмак_CPY.ipt
Башмак_MIR.ipt
Болт шатуна.ipt
В сальник.ipt
Вал.ipt
Верхняя часть коренного подшипника.ipt
Верхняя часть поршня.ipt
Верхняя часть поршня_CPY.ipt
Вилка.ipt
Втулка палец шатун.ipt
Втулка палец шатун_CPY.ipt
Втулка под палец.ipt
Втулка под палец_CPY.ipt
Втулка под палец_MIR.ipt
Втулка.ipt
Втулка_CPY.ipt
Гайка шток-поршень.ipt
Гайка шток-поршень_CPY.ipt
Гайка шток.ipt
Гайка шток_CPY.ipt
Деталь5.ipt
Деталь5_CPY.ipt
Деталь5_CPY_MIR.ipt
Деталь5_CPY_MIR1.ipt
Деталь6.ipt
Деталь6_CPY.ipt
Деталь6_CPY_MIR.ipt
Для регулировки 1.ipt
Для регулировки 2.ipt
Для регулировки 3.ipt
Для регулировки 4.ipt
Дроссельное кольцо.ipt
Дроссельное кольцо_CPY.ipt
Картер всборе.iam
Картер.ipt
Клапан 2.ipt
Клапан/OldVersions/Гайка М24-6H ГОСТ 5915-70.0001.ipt
Клапан/OldVersions/Ограничитель .0002.ipt
Клапан/OldVersions/Пластина.0002.ipt
Клапан/OldVersions/Пружина_1.0003.ipt
Клапан/OldVersions/Седло .0003.ipt
Клапан/OldVersions/Шпилька М24-6gx48 ГОСТ 22038-76.0001.ipt
Клапан/Гайка М24-6H ГОСТ 5915-70.ipt
Клапан/Ограничитель .ipt
Клапан/Пластина.ipt
Клапан/Пружина_1.ipt
Клапан/Седло .ipt
Клапан/Шпилька М24-6gx48 ГОСТ 22038-76.ipt
Клапан0.iam
Клапан1.iam
Клапан1_CPY.iam
Клапан2.iam
Кольцо поршень-шток верх.ipt
Кольцо поршень-шток верх_CPY.ipt
Кольцо поршень-шток низ.ipt
Кольцо поршень-шток низ_CPY.ipt
Кольцо поршня.ipt
Кольцо поршня_CPY.ipt
Кольцо сальника 1.ipt
Кольцо сальника 2.ipt
Кольцо сальника.ipt
Кольцо сальника_CPY.ipt
Корпус в сборе.ipt
Корпус дросселя.ipt
Корпус дросселя_CPY.ipt
Корпус маслосъемника.ipt
Корпус маслосъемника_CPY.ipt
Корпус сальника 1.ipt
Корпус сальника 2.ipt
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
