Narutimo/compressor/(commit log)

2020-11-17 детали
    [Верхняя часть поршня.0002.ipt, Верхняя часть поршня.ipt, Втулка.0003.ipt, Втулка.ipt, Гайка М24-6H ГОСТ 5915-70.igs, Гайка М24-6H ГОСТ 5915-70.ipt, Дроссельное кольцо.0001.ipt, Дроссельное кольцо.ipt]
2020-11-18 детальки
    [Фонарь.0001.ipt, Фонарь.0005.ipt, Фонарь.ipt]
2020-12-05 детали1
    [Балка.ipt, Башмак.0007.ipt, Башмак.ipt, Башмак_MIR.0001.ipt, Башмак_MIR.ipt, Вал.0001.ipt, Вал.ipt, Верхняя часть поршня.0002.ipt]
2020-12-14 почти
    [Балка.0003.ipt, Балка.ipt, Башмак.0007.ipt, Башмак.0008.ipt, Башмак.ipt, Башмак_CPY.ipt, Башмак_MIR.0001.ipt, Башмак_MIR.0002.ipt]
2020-12-18 почтиготов1
    [В сальник.0006.ipt, В сальник.ipt, Клапан 2.0001.ipt, Клапан 2.ipt, Кольцо сальника 1.ipt, Кольцо сальника 2.ipt, Корпус дросселя.0006.ipt, Корпус дросселя.ipt]
2020-12-25 готово
    [3_Лист_1.dxf, 3_Лист_2.dxf, Болт шатуна.0001.ipt, Болт шатуна.ipt, В сальник.0006.ipt, В сальник.0007.ipt, В сальник.ipt, Вал.0007.ipt]
